athralk/ASIC_Design_JaneStreet/blog/images/MAC_Address.jpg

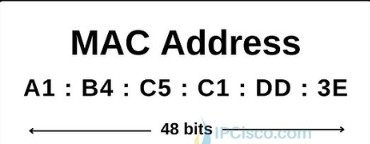
blog/images/MAC_Address.jpg
