athralk/ASIC_Design_JaneStreet/src/tt_um_eth10t.v

module tt_um_eth10t (
    ui_in,
    rst_n,
    clk,
    uio_in,
    ena,
    uo_out,
    uio_out,
    uio_oe
);

    input [7:0] ui_in;
    input rst_n;
    input clk;
    input [7:0] uio_in;
    input ena;
    output [7:0] uo_out;
    output [7:0] uio_out;
    output [7:0] uio_oe;

    wire [7:0] _46;
    wire _187;
    wire _183;
    wire _181;
    wire _184;
    wire _185;
    reg _188;
    wire _173;
    wire [2:0] _150;
    wire _151;
    wire _174;
    wire _175;
    wire _176;
    reg _179;
    wire [1:0] _133;
    wire _130;
    wire _131;
    wire _126;
    wire _132;
    wire _119;
    wire _120;
    wire _109;
    wire _110;
    wire _111;
    wire _112;
    wire _114;
    wire _2;
    reg _103;
    wire _118;
    wire _121;
    wire [7:0] _189;
    wire [7:0] _198;
    wire [7:0] _195;
    wire [7:0] _196;
    wire [7:0] _4;
    reg [7:0] _192;
    wire [6:0] _193;
    wire [7:0] _194;
    wire [7:0] _200;
    wire [7:0] _201;
    wire [7:0] _202;
    wire [7:0] _5;
    reg [7:0] _199;
    wire _254;
    wire _226;
    wire _227;
    wire _255;
    wire _6;
    reg _215;
    wire _279;
    wire _276;
    wire _273;
    wire _274;
    wire _277;
    wire _280;
    wire _7;
    reg _259;
    wire [31:0] _496;
    wire _452;
    wire _450;
    wire _449;
    wire _451;
    wire _453;
    wire _454;
    wire _448;
    wire _455;
    reg _458;
    wire _459;
    wire [31:0] _447;
    wire [31:0] _480;
    wire _466;
    wire [5:0] _169;
    wire _170;
    wire _167;
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
                    _664 };
    assign _676 = _665 < _675;
    assign _677 = ~ _676;
    assign _659 = rx_ph[5:5];
    assign _658 = rx_ph[4:4];
    assign _660 = _658 | _659;
    assign _661 = rx_active & _660;
    assign _678 = _661 & _677;
    always @(posedge _40) begin
        _681 <= _678;
    end
    assign _722 = _681 ? _721 : _718;
    assign _709 = 12'b000000000100;
    assign _708 = 12'b000000000010;
    assign _710 = _565 ? _709 : _708;
    assign _711 = _602 ? _710 : rx_ph;
    assign _723 = rx_active ? _722 : _711;
    assign _37 = _723;
    always @(posedge _40) begin
        if (_48)
            rx_ph <= _53;
        else
            rx_ph <= _37;
    end
    assign _566 = rx_ph[0:0];
    assign _568 = _566 | _567;
    assign _570 = _568 | _569;
    assign _572 = _570 | _571;
    assign _574 = _572 | _573;
    assign _575 = _565 & _574;
    assign _587 = _575 | _586;
    assign _727 = _587 ? _109 : rx_seen;
    assign _729 = _61 ? _187 : _727;
    assign _725 = _602 ? _109 : rx_seen;
    assign _730 = rx_active ? _729 : _725;
    assign _38 = _730;
    always @(posedge _40) begin
        if (_48)
            rx_seen <= _187;
        else
            rx_seen <= _38;
    end
    assign _69 = rx_seen | _68;
    assign _734 = _69 ? rx_active : _187;
    assign _735 = _61 ? _734 : rx_active;
    assign _576 = _564 ^ _552;
    always @(negedge _40) begin
        _558 <= _546;
    end
    always @(posedge _40) begin
        _561 <= _558;
    end
    always @(posedge _40) begin
        _564 <= _561;
    end
    assign vdd = 1'b1;
    assign _40 = clk;
    assign _42 = uio_in;
    assign _546 = _42[2:2];
    always @(posedge _40) begin
        _549 <= _546;
    end
    always @(posedge _40) begin
        _552 <= _549;
    end
    always @(posedge _40) begin
        _555 <= _552;
    end
    assign _565 = _555 ^ _564;
    assign _602 = _565 | _576;
    assign _732 = _602 ? _109 : rx_active;
    assign _736 = rx_active ? _735 : _732;
    assign _43 = _736;
    always @(posedge _40) begin
        if (_48)
            rx_active <= _187;
        else
            rx_active <= _43;
    end
    assign _58 = rx_active & _57;
    always @(posedge _40) begin
        _61 <= _58;
    end
    assign _508 = _61 & _507;
    always @(posedge _40) begin
        _511 <= _508;
    end
    assign _512 = _511 & rx_in_frame;
    assign _740 = _512 ? _187 : _738;
    assign _44 = _740;
    always @(posedge _40) begin
        if (_48)
            rx_in_frame <= _187;
        else
            rx_in_frame <= _44;
    end
    assign _742 = rx_in_frame ? _199 : _741;
    assign uo_out = _742;
    assign uio_out = _189;
    assign uio_oe = _46;

endmodule
